lamidas/ESP32-S3_audio_control_board/image/board shape_GPT.png

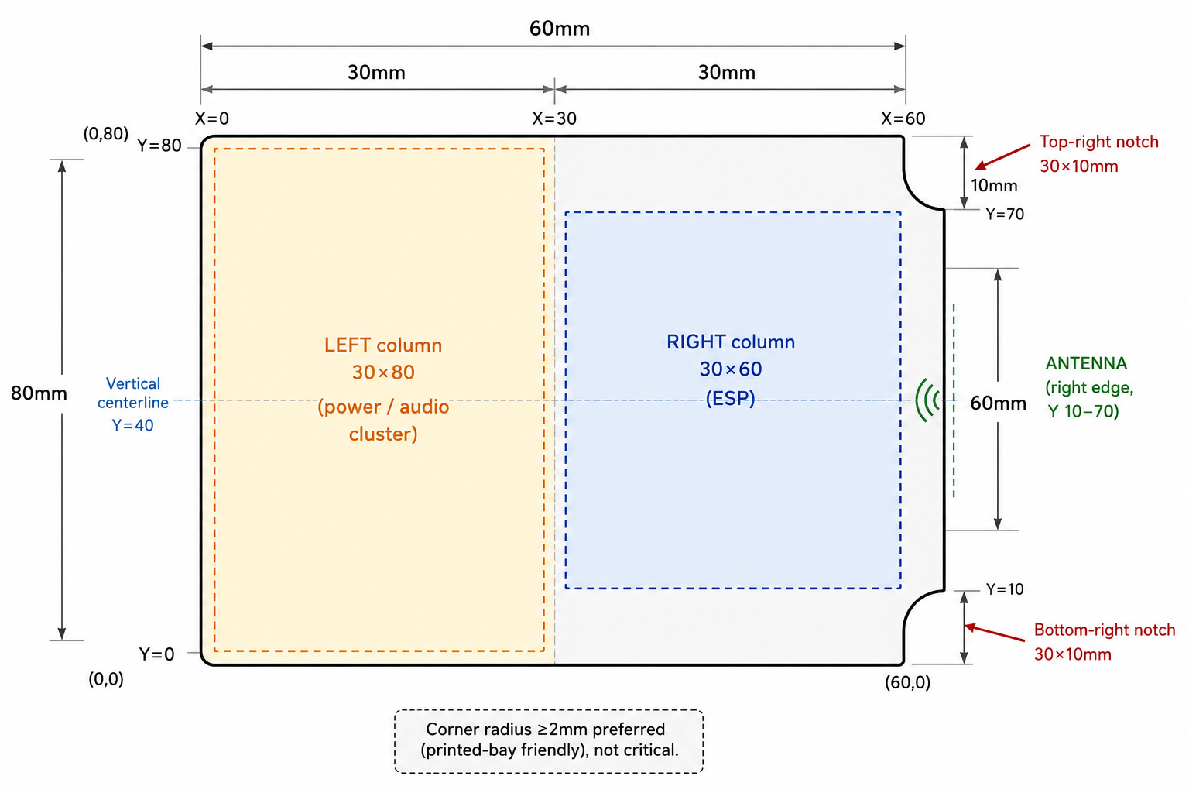
image/board shape_GPT.png
