lamidas/ESP32-S3_audio_control_board/Zachary/ee-brief/04-schematic/connectivity.png

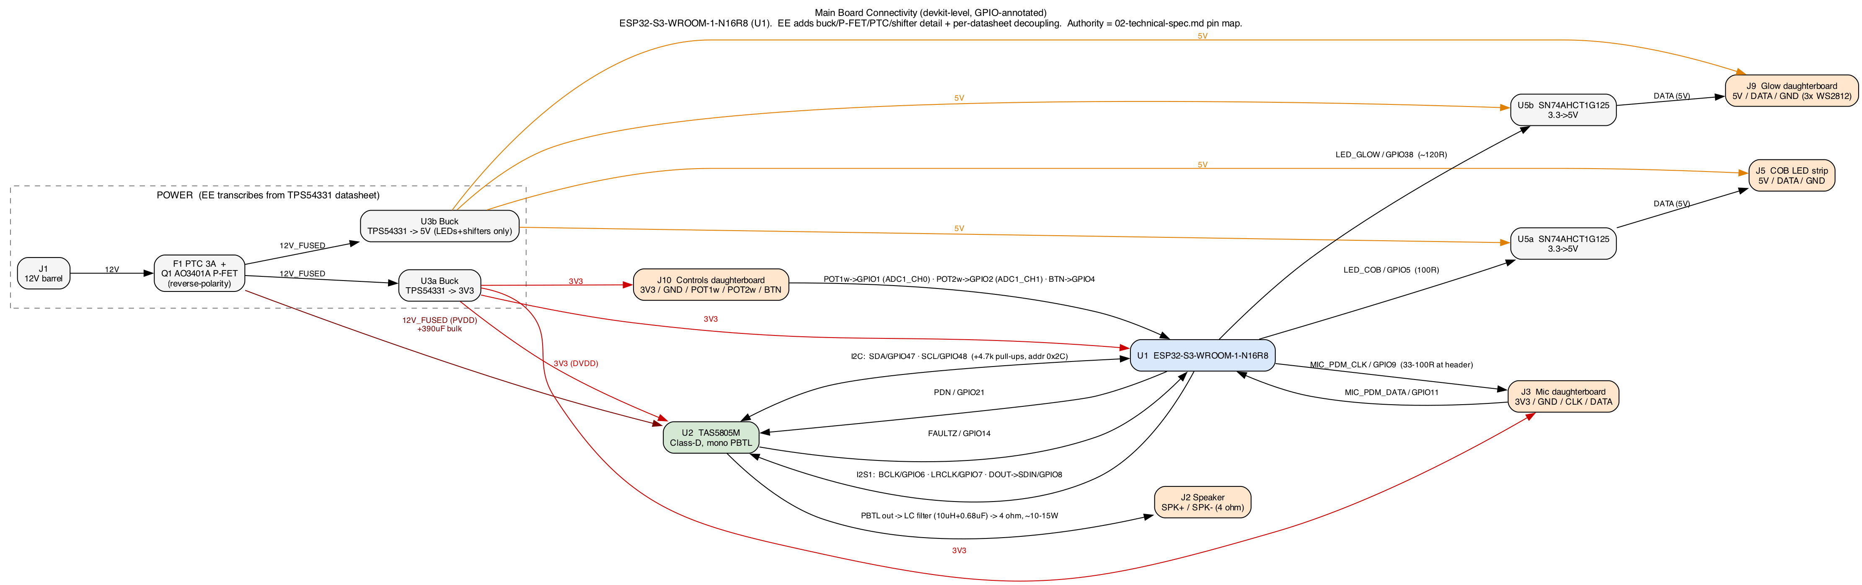
Zachary/ee-brief/04-schematic/connectivity.png
