lamidas/ESP32-S3_audio_control_board/Zachary/ee-brief/04-schematic/connectivity.pdf

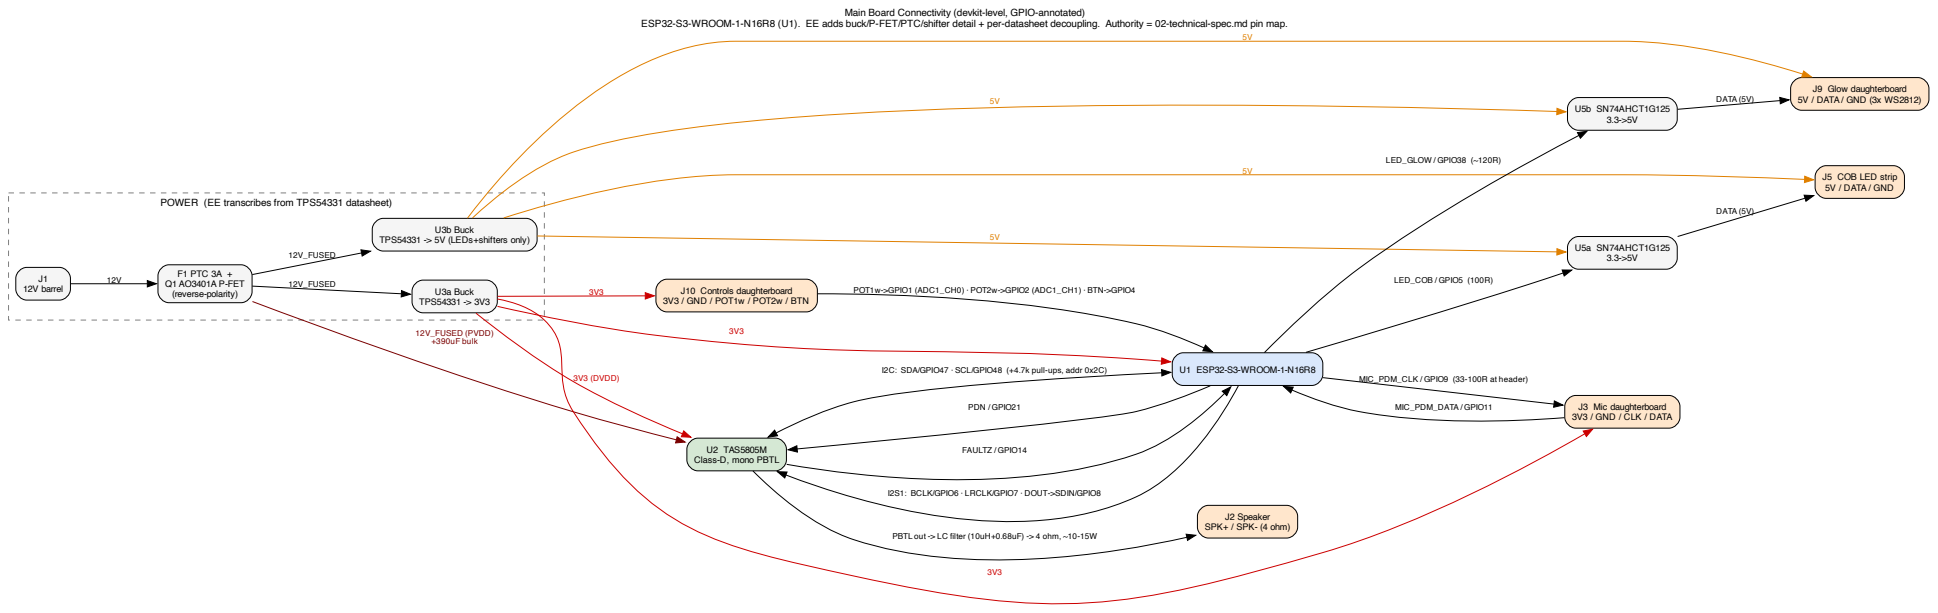
[picture p3: page 1]

Main Board Connectivity (devkit-level, GPIO-annotated)

ESP32-S3-WROOM-1-N16R8 (U1). EE adds buck/P-FET/PTC/shifter detail + per-datasheet decoupling. Authority = 02-technical-spec.md pin map.

POWER (EE transcribes from TPS54331 datasheet)

I2C: SDA/GPIO47 · SCL/GPIO48 (+4.7k pull-ups, addr 0x2C)

I2S1: BCLK/GPIO6 · LRCLK/GPIO7 · DOUT->SDIN/GPIO8

PBTL out -> LC filter (10uH+0.68uF) -> 4 ohm, ~10-15W
