lamidas/ESP32-S3_audio_control_board/ESP32-S3_Audio_Control_Board_0709/ESP32-S3_Audio_Control_Board.kicad_pcb

## KiCad design ESP32-S3_Audio_Control_Board_0709/ESP32-S3_Audio_Control_Board.kicad_pcb (2026-07-15)

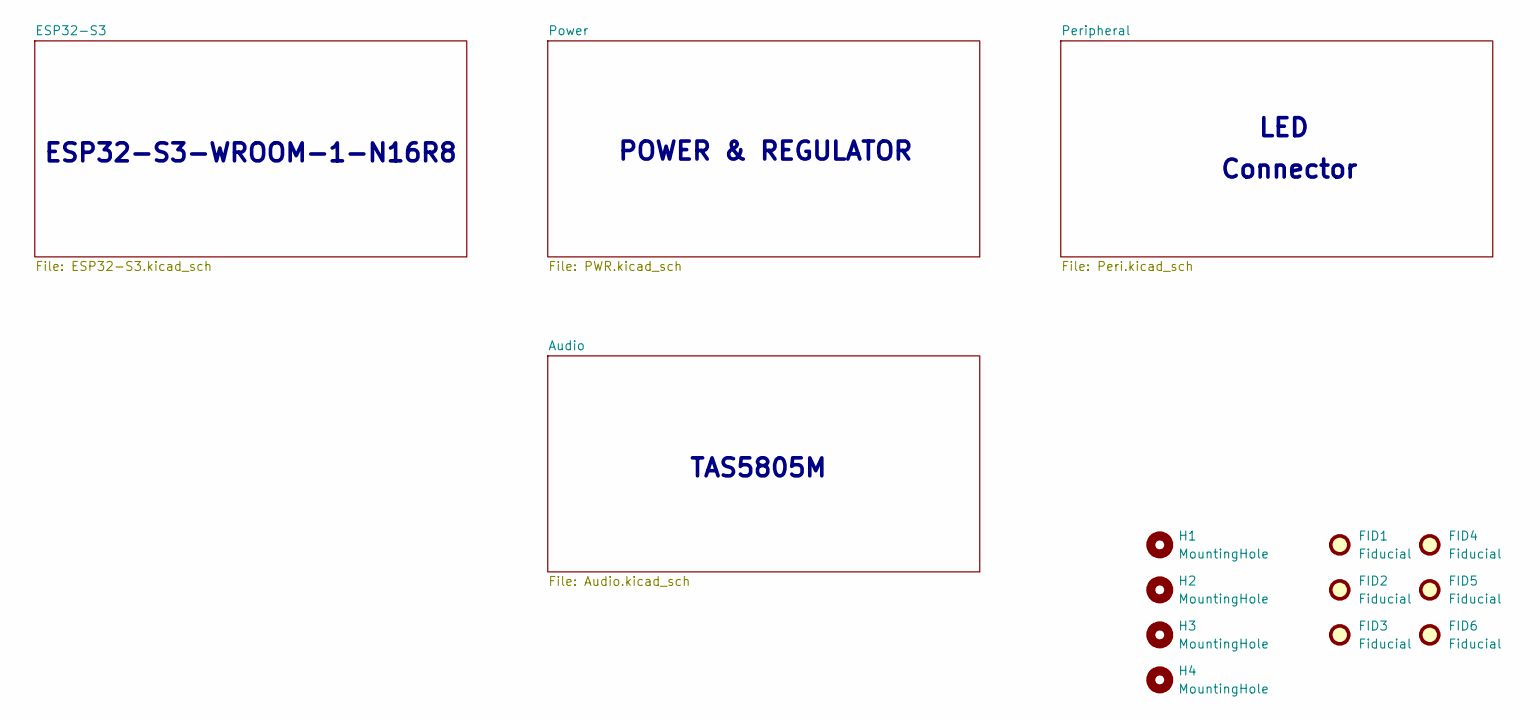
[picture p4: schematic ESP32-S3_Audio_Control_Board.kicad_sch, ESP32-S3 Audio Control Board]

Parts:
FID1, FID2, FID3, FID4, FID5, FID6: Fiducial; Fiducial_1mm_Mask2mm
H1, H2, H3, H4: MountingHole; MountingHole_3.5mm

Notes on the sheet:
ESP32-S3-WROOM-1-N16R8
Connector
TAS5805M
LED
POWER & REGULATOR

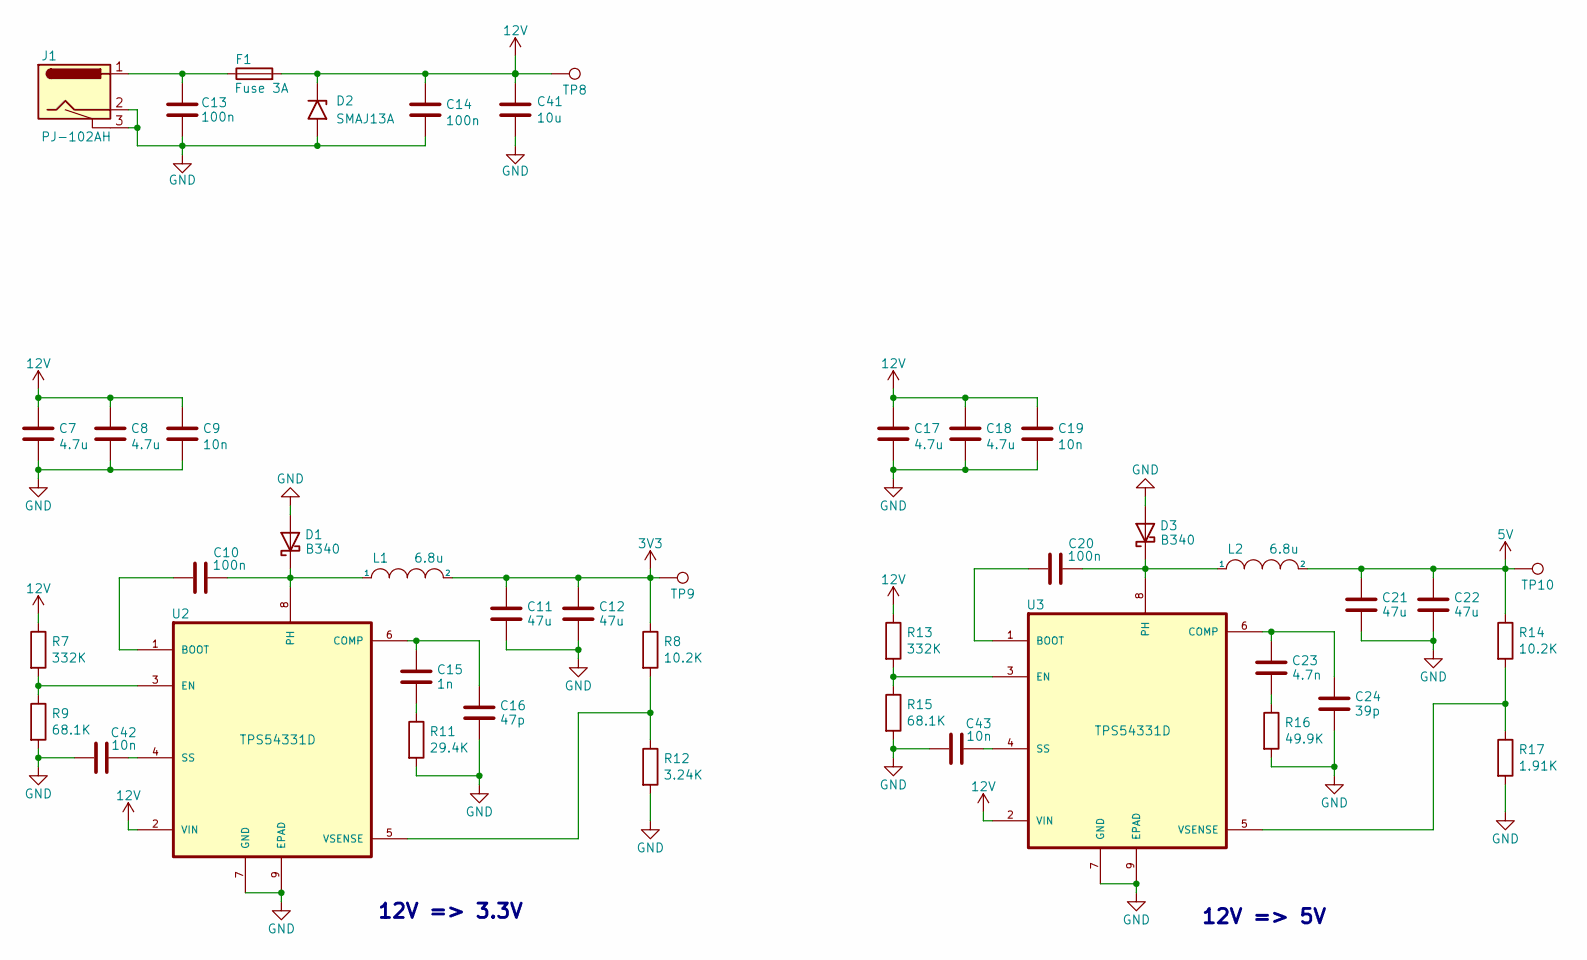
[picture p5: schematic PWR.kicad_sch, Power]

Parts:
C7, C8, C17, C18: 4.7u; C_0805_2012Metric; Mfr PN GRM21BZ7YA475KE15K
C9, C19, C42, C43: 10n; C_0402_1005Metric; Mfr PN CC0402KRX7R9BB103
C10, C14, C20: 100n; C_0402_1005Metric; Mfr PN GCM155R71H104KE02D
C11, C12, C21, C22: 47u; C_1210_3225Metric; Mfr PN GRM32ER61C476KE15L
C13: 100n; C_0402_1005Metric; Part Description CAP CER 100nF 50V X7R 0402
C15: 1n; C_0402_1005Metric; Mfr PN GRM155R71H102KA01D
C16: 47p; C_0402_1005Metric; Mfr PN GRM1555C1H470JA01D
C23: 4.7n; C_0402_1005Metric; Mfr PN CC0402KRX7R9BB472
C24: 39p; C_0402_1005Metric; Mfr PN CC0402JRNPO9BN390
C41: 10u; C_0805_2012Metric; Mfr PN GRM21BR6YA106KE43L
D1, D3: B340; D_SMA; Mfr PN B340A
D2: SMAJ13A; D_SMA; Mfr PN SMAJ13A
F1: Fuse 3A; R_1812_4532Metric; Mfr PN SMD1812P300SLR/24
J1: PJ-102AH; BarrelJack_CUI_PJ-102AH_Horizontal; Mfr PN PJ-102AH
L1, L2: 6.8u; L_Sunlord_MWSA0602S; Mfr PN FXL0630-6R8-M
R7, R13: 332K; R_0402_1005Metric; Mfr PN 0402WGF3323TCE
R8, R14: 10.2K; R_0402_1005Metric; Mfr PN RC0402FR-0710K2L
R9, R15: 68.1K; R_0402_1005Metric; Mfr PN 0402WGF6812TCE
R11: 29.4K; R_0402_1005Metric; Mfr PN AT0402DRD0729K4L
R12: 3.24K; R_0402_1005Metric; Mfr PN 0402WGF3241TCE
R16: 49.9K; R_0402_1005Metric; Mfr PN ERJ2RKF4992X
R17: 1.91K; R_0402_1005Metric; Mfr PN 0402WGF1911TCE
TP8, TP9, TP10: IO0; TestPoint_Pad_D1.5mm
U2, U3: TPS54331D; SOIC-8-1EP_3.9x4.9mm_P1.27mm_EP2.29x3mm; Mfr PN TPS54331DR

Connections:
3V3: C11.2, C12.2, L1.2, R8.1, TP9.1 (1_1); also elsewhere on the board
5V: C21.2, C22.2, L2.2, R14.1, TP10.1 (1_1); also elsewhere on the board
12V: C7.1, C8.1, C9.1, C14.1, C17.1, C18.1, C19.1, C41.1, D2.1 (A1), F1.2, R7.1, R13.1, TP8.1 (1_1), U2.2 (VIN), U3.2 (VIN); also elsewhere on the board
GND: C7.2, C8.2, C9.2, C11.1, C12.1, C13.2, C14.2, C16.1, C17.2, C18.2, C19.2, C21.1, C22.1, C24.1, C41.2, C42.1, C43.1, D1.2 (A), D2.2 (A2), D3.2 (A), J1.2, J1.3, R9.2, R11.2, R12.2, R15.2, R16.2, R17.2, U2.7 (GND), U2.9 (EPAD), U3.7 (GND), U3.9 (EPAD); also elsewhere on the board
unnamed: C13.1, F1.1, J1.1
unnamed: C15.1, R11.1
unnamed: C23.1, R16.1
unnamed: C10.2, D1.1 (K), L1.1, U2.8 (PH)
unnamed: C20.2, D3.1 (K), L2.1, U3.8 (PH)
unnamed: C10.1, U2.1 (BOOT)
unnamed: C15.2, C16.2, U2.6 (COMP)
unnamed: R7.2, R9.1, U2.3 (EN)
unnamed: C42.2, U2.4 (SS)
unnamed: R8.2, R12.1, U2.5 (VSENSE)
unnamed: C20.1, U3.1 (BOOT)
unnamed: C23.2, C24.2, U3.6 (COMP)
unnamed: R13.2, R15.1, U3.3 (EN)
unnamed: C43.2, U3.4 (SS)
unnamed: R14.2, R17.1, U3.5 (VSENSE)

Notes on the sheet:
12V => 3.3V
12V => 5V

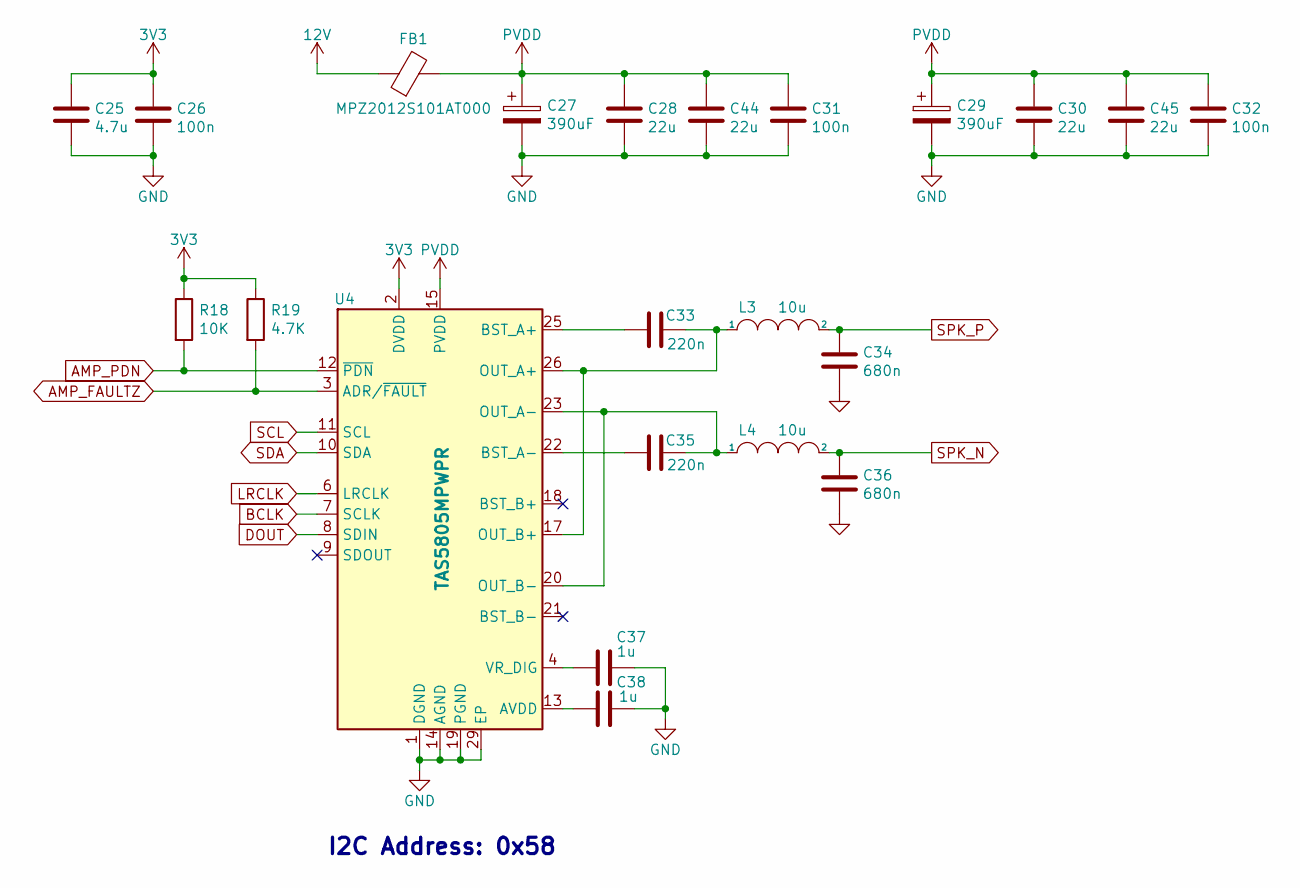
[picture p6: schematic Audio.kicad_sch]

Parts:
C25: 4.7u; C_0603_1608Metric; Mfr PN GRM188R61A475KE15D
C26: 100n; C_0402_1005Metric; Mfr PN GCM155R71H104KE02D
C27, C29: 390uF; CP_Elec_8x10.5; Mfr PN HV1E397M0810PZ
C28, C30, C44, C45: 22u; C_1206_3216Metric; Mfr PN GRM31CR61E226KE15L
C31, C32: 100n; C_0603_1608Metric; Mfr PN GCJ188R71E104KA12D
C33, C35: 220n; C_0603_1608Metric; Mfr PN GCM188R71H224KA64D
C34, C36: 680n; C_1206_3216Metric; Mfr PN CC1206KKX7R9BB684
C37, C38: 1u; C_0402_1005Metric; Mfr PN GRM155R61H105KE05D
FB1: MPZ2012S101AT000; Fuse_0805_2012Metric; Mfr PN MPZ2012S101AT000
L3, L4: 10u; L_KOHERelec_MDA7030; Mfr PN PSPMAA063T-100M-ANP
R18: 10K; R_0402_1005Metric; Mfr PN RC0402FR-0710KL
R19: 4.7K; R_0402_1005Metric; Mfr PN 0402WGF4701TCE
U4: TAS5805MPWPR; TSSOP-28-1EP_4.4x9.7mm_P0.65mm_EP3.4x9.7mm_Mask3.1x4.05mm_T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; Mfr PN TAS5805MPWPR

Connections:
3V3: C25.1, C26.1, R18.1, R19.1, U4.2 (DVDD); also elsewhere on the board
12V: FB1.1; also elsewhere on the board
AMP_FAULTZ: R19.2, U4.3 (ADR/~FAULT); also elsewhere on the board
AMP_PDN: R18.2, U4.12 (~PDN); also elsewhere on the board
BCLK: U4.7 (SCLK); also elsewhere on the board
DOUT: U4.8 (SDIN); also elsewhere on the board
GND: C25.2, C26.2, C27.2, C28.2, C29.2, C30.2, C31.2, C32.2, C34.1, C36.1, C37.2, C38.2, C44.2, C45.2, U4.1 (DGND), U4.5 (DGND), U4.14 (AGND), U4.19 (PGND), U4.24 (PGND), U4.29 (EP); also elsewhere on the board
LRCLK: U4.6 (LRCLK); also elsewhere on the board
unnamed: C38.1, U4.13 (AVDD)
unnamed: C33.1, U4.25 (BST_A+)
unnamed: C35.1, U4.22 (BST_A-)
unnamed: C33.2, L3.1, U4.17 (OUT_B+), U4.26 (OUT_A+)
unnamed: C35.2, L4.1, U4.20 (OUT_B-), U4.23 (OUT_A-)
unnamed: C37.1, U4.4 (VR_DIG)
PVDD: C27.1, C28.1, C29.1, C30.1, C31.1, C32.1, C44.1, C45.1, FB1.2, U4.15 (PVDD), U4.16 (PVDD), U4.27 (PVDD), U4.28 (PVDD)
SCL: U4.11 (SCL); also elsewhere on the board
SDA: U4.10 (SDA); also elsewhere on the board
SPK_N: C36.2, L4.2; also elsewhere on the board
SPK_P: C34.2, L3.2; also elsewhere on the board

Notes on the sheet:
I2C Address: 0x58

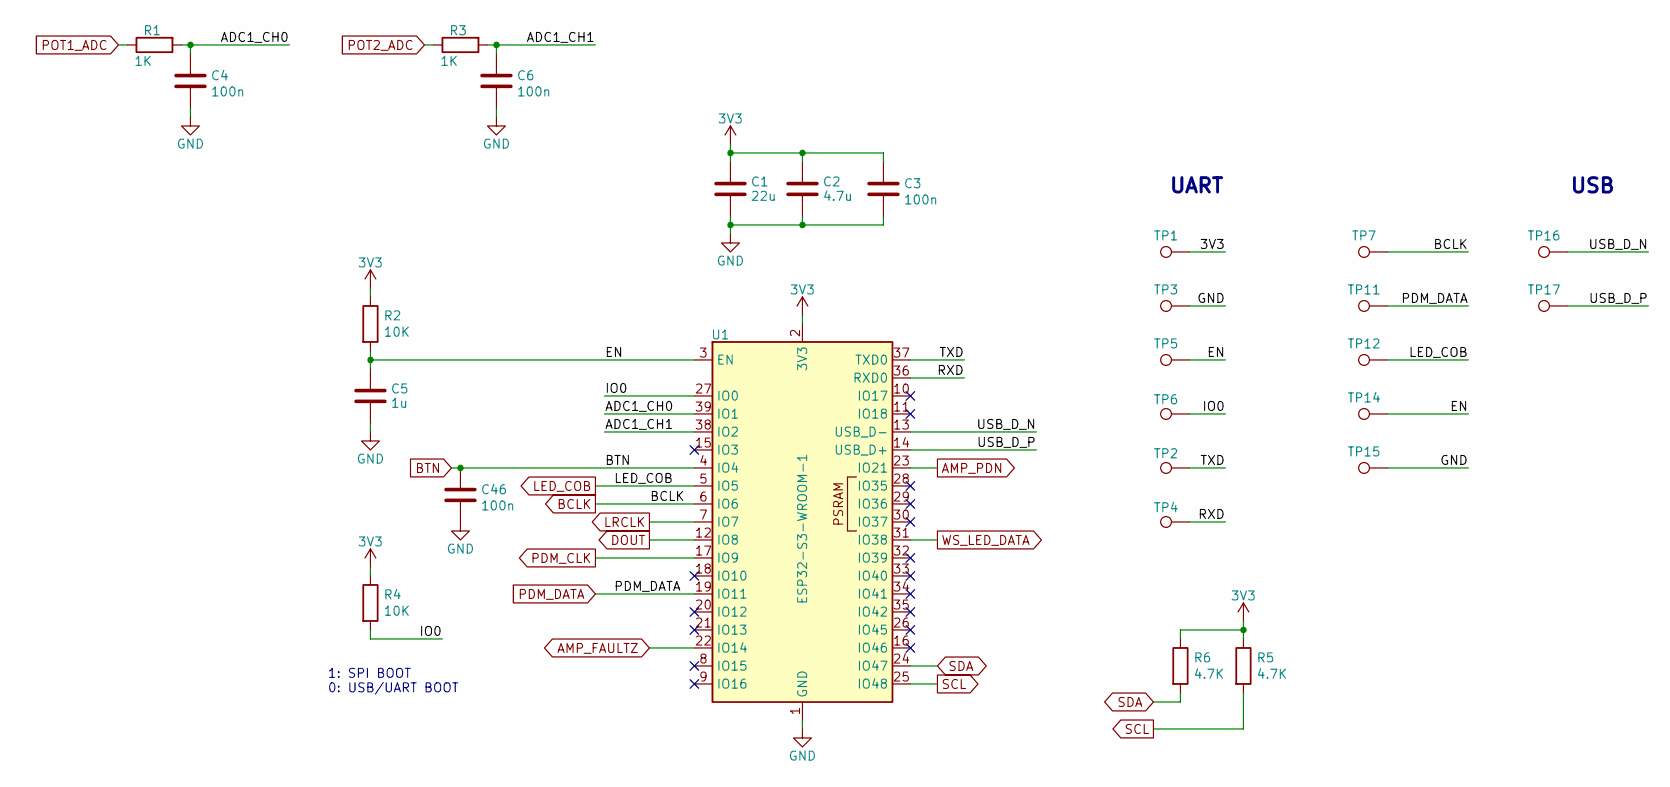
[picture p7: schematic ESP32-S3.kicad_sch]

Parts:
C1: 22u; C_0603_1608Metric; Mfr PN GRM188R61A226ME15D
C2: 4.7u; C_0402_1005Metric; Mfr PN GRM155R61A475KEAAD
C3, C4, C6, C46: 100n; C_0402_1005Metric; Mfr PN GCM155R71H104KE02D
C5: 1u; C_0402_1005Metric; Mfr PN GRM155R61H105KE05D
R1, R3: 1K; R_0402_1005Metric; Mfr PN 0402WGF1001TCE
R2, R4: 10K; R_0402_1005Metric; Mfr PN RC0402FR-0710KL
R5, R6: 4.7K; R_0402_1005Metric; Mfr PN 0402WGF4701TCE
TP1, TP2, TP3, TP4, TP5, TP6, TP7, TP11, TP12, TP14, TP15, TP16, TP17: IO0; TestPoint_Pad_D1.5mm
U1: ESP32-S3-WROOM-1; Mfr PN ESP32-S3-WROOM-1-N16R8

Connections:
3V3: C1.1, C2.1, C3.1, R2.1, R4.1, R5.1, R6.1, TP1.1 (1_1), U1.2 (3V3); also elsewhere on the board
/ESP32-S3/ADC1_CH0: C4.1, R1.2, U1.39 (IO1)
/ESP32-S3/ADC1_CH1: C6.1, R3.2, U1.38 (IO2)
/ESP32-S3/EN: C5.1, R2.2, TP5.1 (1_1), TP14.1 (1_1), U1.3 (EN)
/ESP32-S3/IO0: R4.2, TP6.1 (1_1), U1.27 (IO0)
/ESP32-S3/RXD: TP4.1 (1_1), U1.36 (RXD0)
/ESP32-S3/TXD: TP2.1 (1_1), U1.37 (TXD0)
/ESP32-S3/USB_D_N: TP16.1 (1_1), U1.13 (USB_D-)
/ESP32-S3/USB_D_P: TP17.1 (1_1), U1.14 (USB_D+)
AMP_FAULTZ: U1.22 (IO14); also elsewhere on the board
AMP_PDN: U1.23 (IO21); also elsewhere on the board
BCLK: TP7.1 (1_1), U1.6 (IO6); also elsewhere on the board
BTN: C46.1, U1.4 (IO4); also elsewhere on the board
DOUT: U1.12 (IO8); also elsewhere on the board
GND: C1.2, C2.2, C3.2, C4.2, C5.2, C6.2, C46.2, TP3.1 (1_1), TP15.1 (1_1), U1.1 (GND), U1.40 (GND), U1.41 (GND); also elsewhere on the board
LED_COB: TP12.1 (1_1), U1.5 (IO5); also elsewhere on the board
LRCLK: U1.7 (IO7); also elsewhere on the board
PDM_CLK: U1.17 (IO9); also elsewhere on the board
PDM_DATA: TP11.1 (1_1), U1.19 (IO11); also elsewhere on the board
POT1_ADC: R1.1; also elsewhere on the board
POT2_ADC: R3.1; also elsewhere on the board
SCL: R5.2, U1.25 (IO48); also elsewhere on the board
SDA: R6.2, U1.24 (IO47); also elsewhere on the board
WS_LED_DATA: U1.31 (IO38); also elsewhere on the board

Notes on the sheet:
UART
1: SPI BOOT 0: USB/UART BOOT
USB

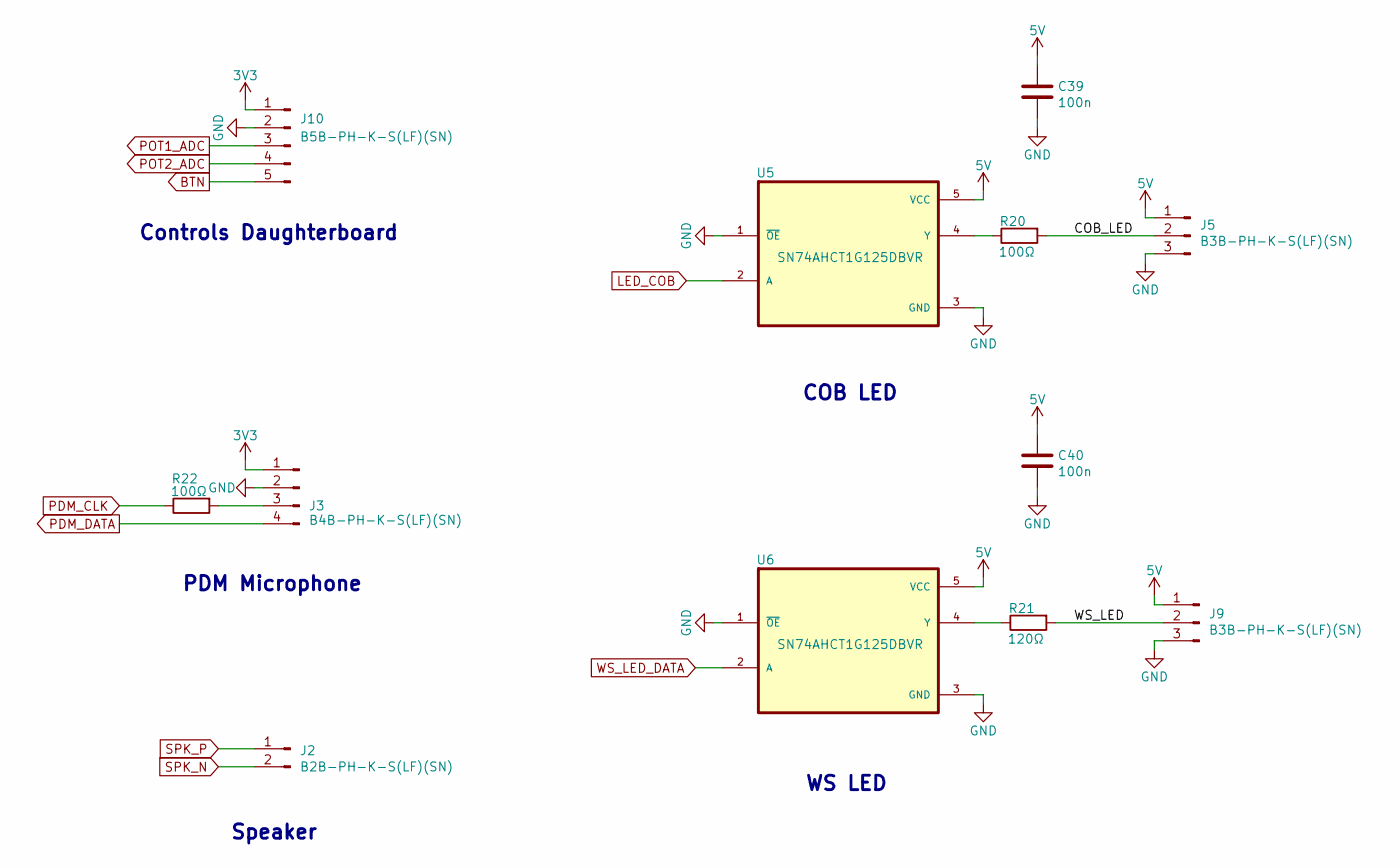
[picture p8: schematic Peri.kicad_sch, Peripherals]

Parts:
C39, C40: 100n; C_0402_1005Metric; Mfr PN GCM155R71H104KE02D
J2: B2B-PH-K-S(LF)(SN); JST_PH_B2B-PH-K_1x02_P2.00mm_Vertical; Mfr PN B2B-PH-K-S(LF)(SN)
J3: B4B-PH-K-S(LF)(SN); JST_PH_B4B-PH-K_1x04_P2.00mm_Vertical; Mfr PN B4B-PH-K-S(LF)(SN)
J5, J9: B3B-PH-K-S(LF)(SN); JST_PH_B3B-PH-K_1x03_P2.00mm_Vertical; Mfr PN B3B-PH-K-S(LF)(SN)
J10: B5B-PH-K-S(LF)(SN); JST_PH_B5B-PH-K_1x05_P2.00mm_Vertical; Mfr PN B5B-PH-K-S(LF)(SN)
R20, R22: 100Ω; R_0402_1005Metric; Mfr PN 0402WGF1000TCE
R21: 120Ω; R_0402_1005Metric; Mfr PN ERJ2RKF1200X
U5, U6: SN74AHCT1G125DBVR; SOT-23-5; Mfr PN SN74AHCT1G125DBVR

Connections:
3V3: J3.1, J10.1; also elsewhere on the board
5V: C39.1, C40.1, J5.1, J9.1, U5.5 (VCC), U6.5 (VCC); also elsewhere on the board
/Peripheral/COB_LED: J5.2, R20.2
/Peripheral/WS_LED: J9.2, R21.2
BTN: J10.5; also elsewhere on the board
GND: C39.2, C40.2, J3.2, J5.3, J9.3, J10.2, U5.1 (~OE), U5.3 (GND), U6.1 (~OE), U6.3 (GND); also elsewhere on the board
LED_COB: U5.2 (A); also elsewhere on the board
unnamed: J3.3, R22.2
unnamed: R20.1, U5.4 (Y)
unnamed: R21.1, U6.4 (Y)
PDM_CLK: R22.1; also elsewhere on the board
PDM_DATA: J3.4; also elsewhere on the board
POT1_ADC: J10.3; also elsewhere on the board
POT2_ADC: J10.4; also elsewhere on the board
SPK_N: J2.2; also elsewhere on the board
SPK_P: J2.1; also elsewhere on the board
WS_LED_DATA: U6.2 (A); also elsewhere on the board

Notes on the sheet:
Speaker
WS LED
COB LED
PDM Microphone
Controls Daughterboard

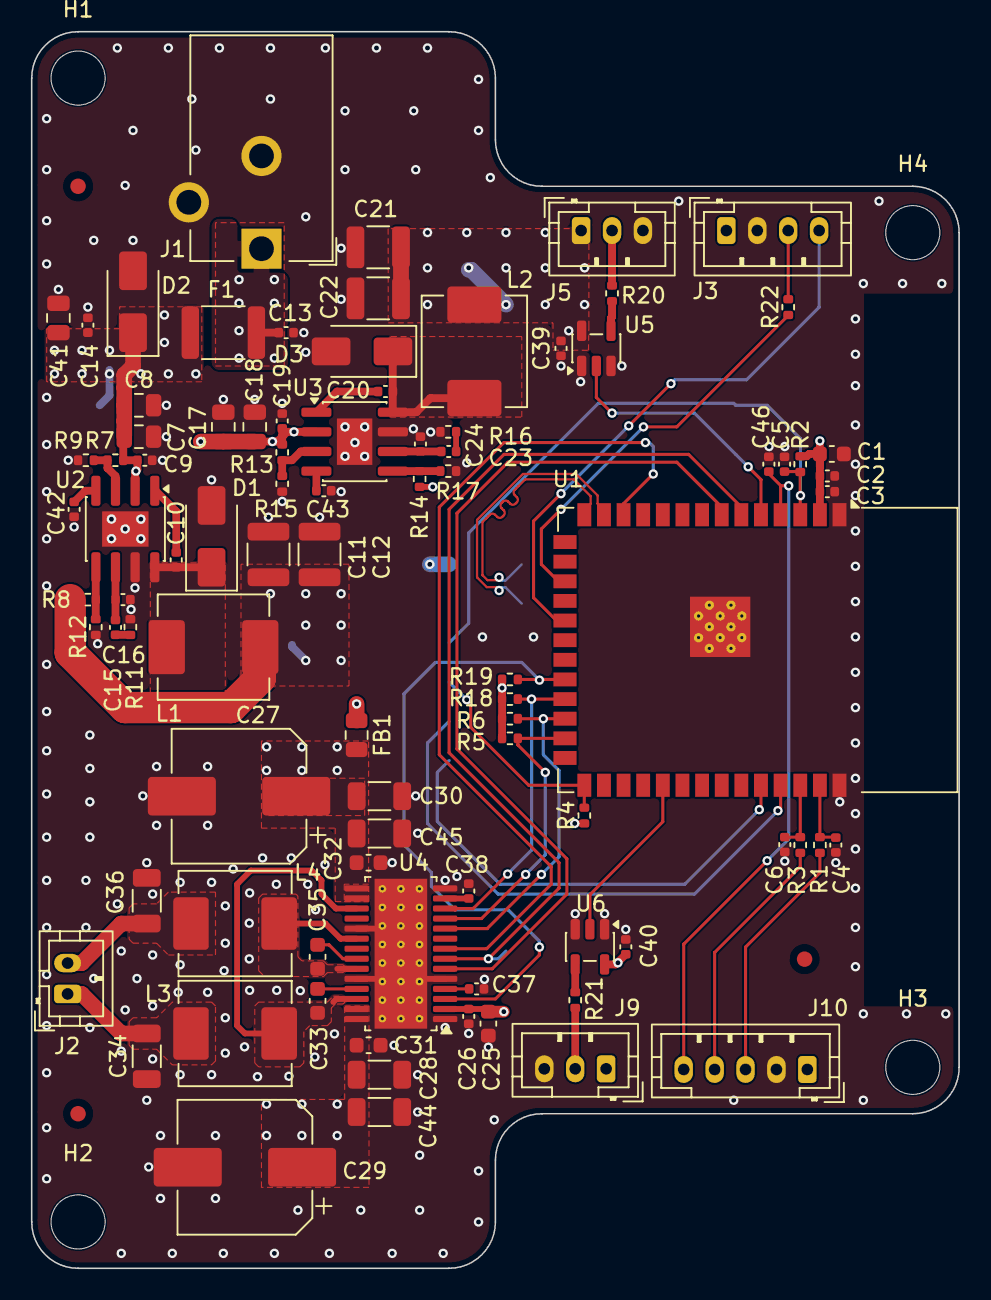
[picture p9: board ESP32-S3_Audio_Control_Board.kicad_pcb from above]

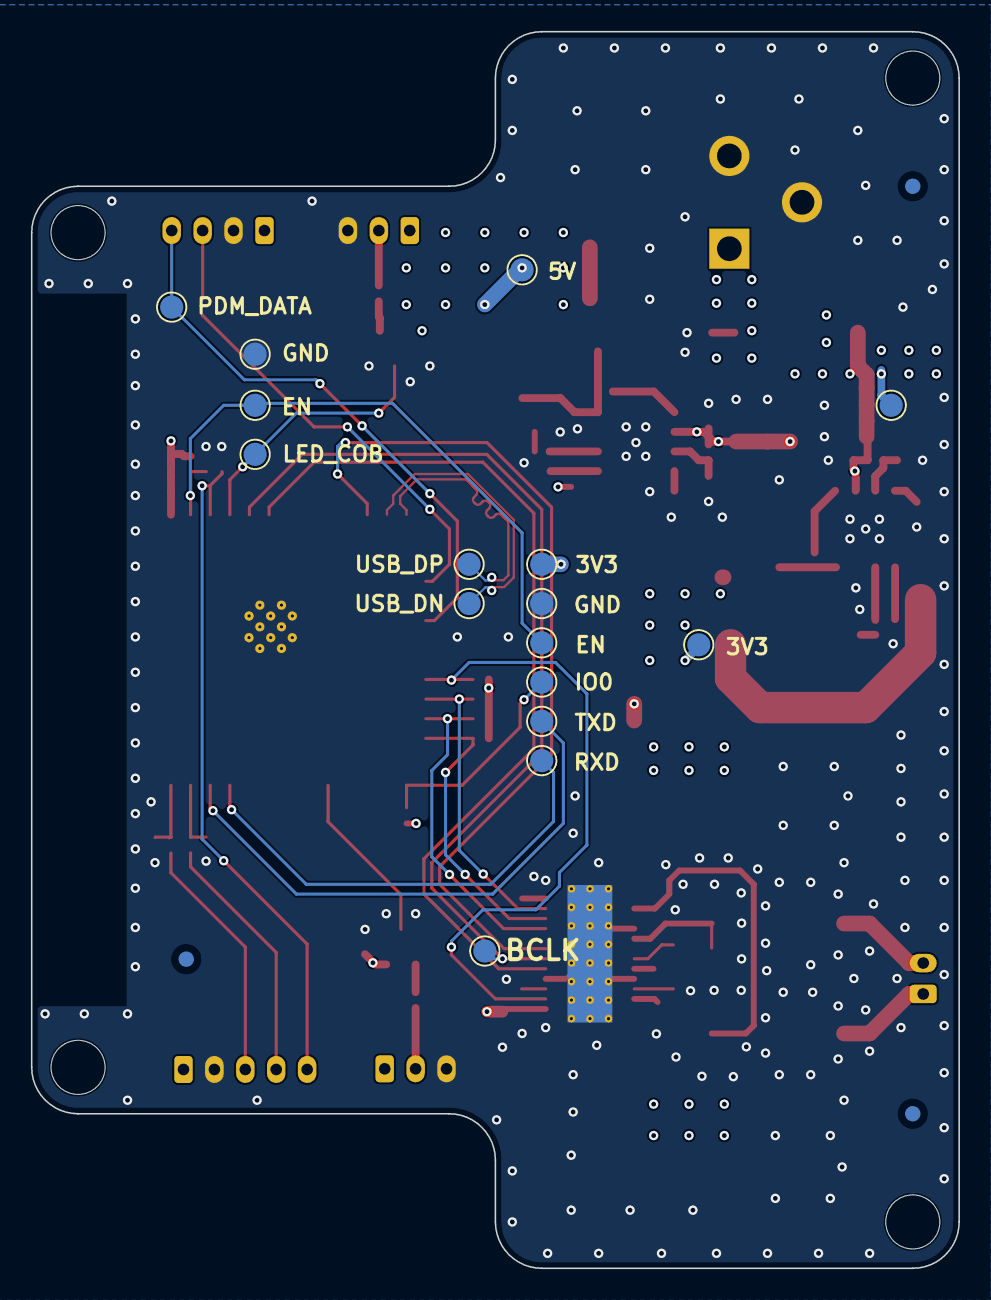
[picture p10: board ESP32-S3_Audio_Control_Board.kicad_pcb from below]

Board: 4 copper layers, 60.0 x 80.0 mm, 114 parts (19 on the bottom side), 55 nets.
