lamidas/ESP32-S3_audio_control_board/project source/ESP32-S3_Audio_Control_Board/csi.kicad_sch

## KiCad design project source/ESP32-S3_Audio_Control_Board/csi.kicad_sch (2026-07-01)

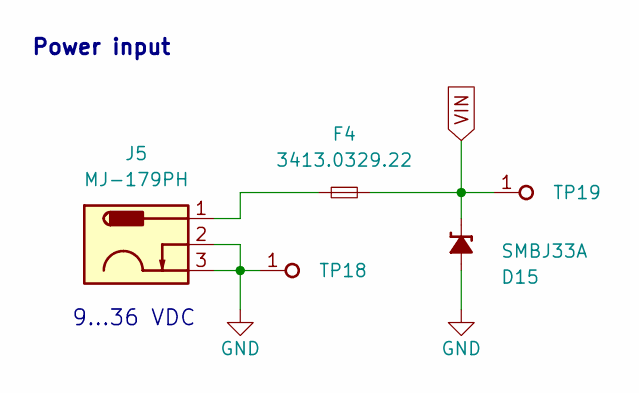
[picture p11: schematic csi.kicad_sch]

Parts:
D15: SMBJ33A; D_SMB; MPN SMBJ33A
F4: F_12A_1206; F_1206_3216Metric; MPN 3413.0329.22
J5: BarrelJack_Pin2mm_MJ-179PH; MPN MJ-179PH
TP18, TP19: TP_1.5mm_SMD; TP_SMD_1.5mm

Connections:
GND: D15.2 (A), J5.2, J5.3, TP18.1
unnamed: F4.1, J5.1
VIN: D15.1 (C), F4.2, TP19.1

Notes on the sheet:
9...36 VDC
Power input
