lamidas/ESP32-S3_audio_control_board/(commit log)

2026-07-09 update TAS5805, 4-layer
    [Audio.kicad_sch, ESP32-S3.kicad_sch, ESP32-S3_Audio_Control_Board.kicad_pcb]
2026-07-09 resolve feedback
    [Audio.kicad_sch, ESP32-S3.kicad_sch, ESP32-S3_Audio_Control_Board.kicad_pcb, ESP32-S3_Audio_Control_Board.kicad_sch, PWR.kicad_sch, Peri.kicad_sch]
2026-07-13 update PCB
    [ESP32-S3.kicad_sch, ESP32-S3_Audio_Control_Board.kicad_pcb]
