lamidas/ESP32-S3_audio_control_board/(notices)

Notices in the files:
parts and their libraries:
License: Apache-2.0
